ameisso/KicadLib/SK6812MINI-E v1.step

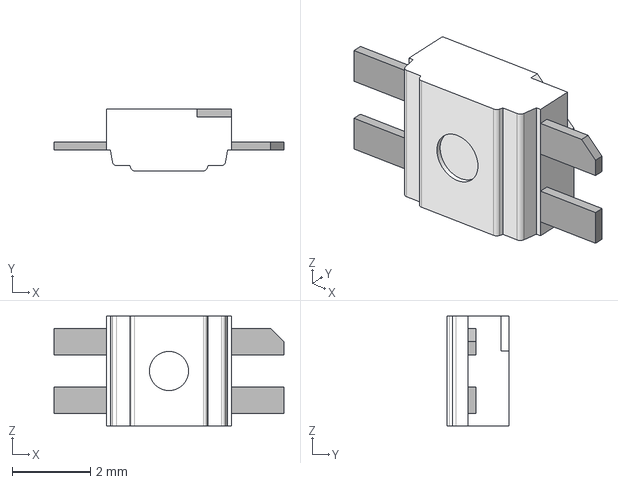
[picture p1: CAD file, 2025-07-12]
SK6812MINI-E v1.step
5.88 x 1.58 x 2.80 mm
