ameisso/KicadLib/(commit log)

2017-04-27 New : LM1117 3V3 regulator
2017-04-27 Fix : TO220 horizontal package pin number
2017-06-20 New : 3.5mm LDR footprint
2017-06-21 New : mechanical hole 1mm
2017-06-21 New : Surface connection 3 pin
2020-02-11 New : tatoo machine footprints
2024-01-11 New : spdt switch footprint
2025-07-12 New : sk6812, Alps Fader, screen ...
    [SK6812MINI-E v1.step]
